harshcht/cummins-auxilliary-boards/aux_PS/3d/PXO7812-500-S.stp

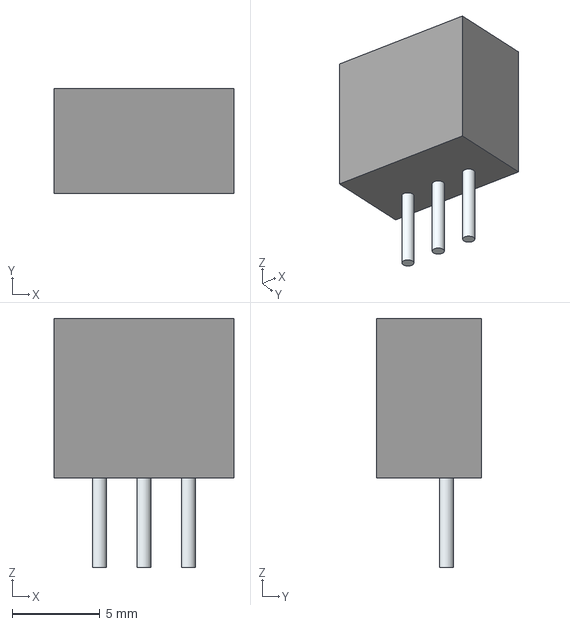
[picture p1: CAD file, 2023-04-08]
aux_PS/3d/PXO7812-500-S.stp
10.3 x 6.00 x 14.2 mm
Leads
