harshcht/cummins-auxilliary-boards/DSP_board/3d/SN74S1053NSR.stp

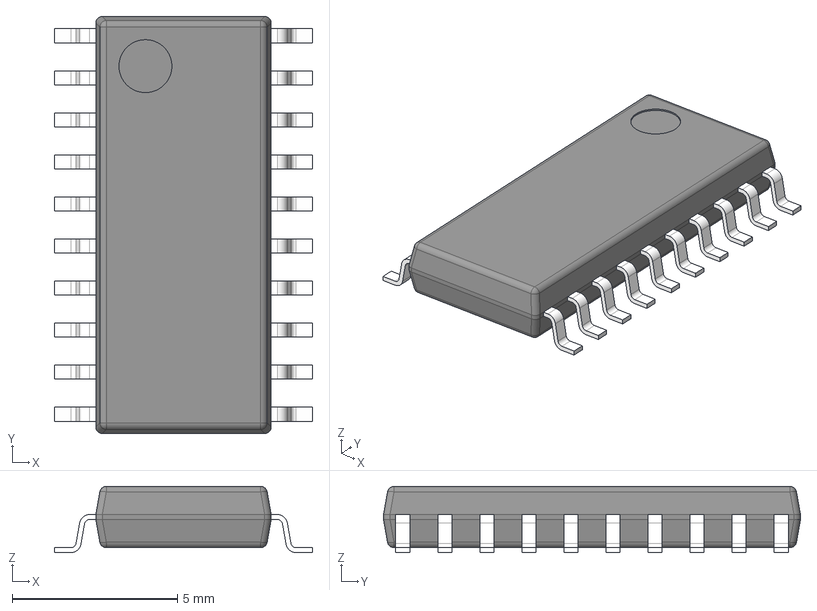
[picture p2: CAD file, 2023-04-17]
DSP_board/3d/SN74S1053NSR.stp
7.80 x 12.6 x 2.00 mm
BODY-SO
LEAD-SO x 20
