harshcht/cummins-auxilliary-boards/LM358S-13/3D/LM358S-13.stp

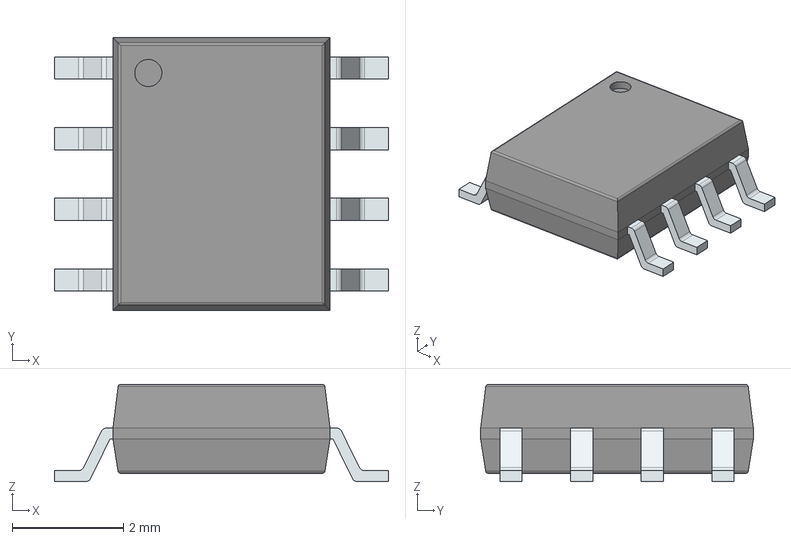
[picture p3: CAD file, 2023-03-20]
LM358S-13/3D/LM358S-13.stp
6.00 x 4.90 x 1.75 mm
PinsArrayLR
