harshcht/cummins-auxilliary-boards/aux_PS/3d/P78E03-1000.stp

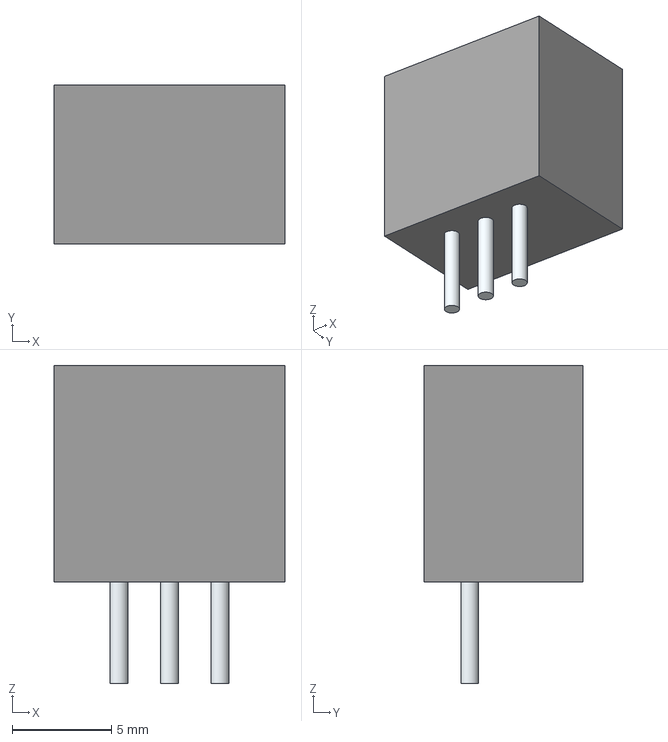
[picture p4: CAD file, 2023-04-08]
aux_PS/3d/P78E03-1000.stp
11.6 x 8.00 x 16.0 mm
Leads
