harshcht/cummins-auxilliary-boards/DSP_board/3d/SDM10M45SD-7-F.stp

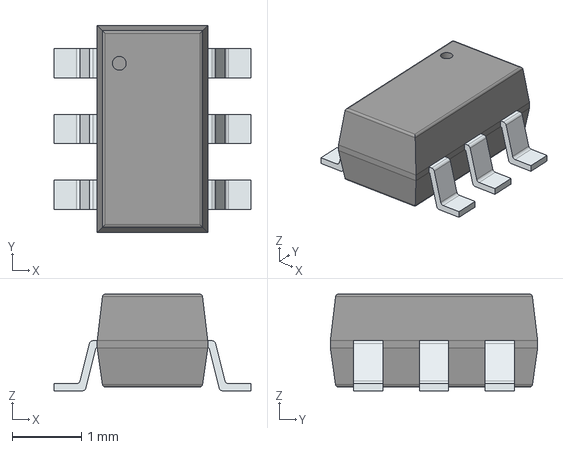
[picture p5: CAD file, 2023-04-17]
DSP_board/3d/SDM10M45SD-7-F.stp
2.85 x 3.00 x 1.40 mm
PinsArrayLR
