harshcht/cummins-auxilliary-boards/aux_PS/3d/PSK-S6C-24.stp

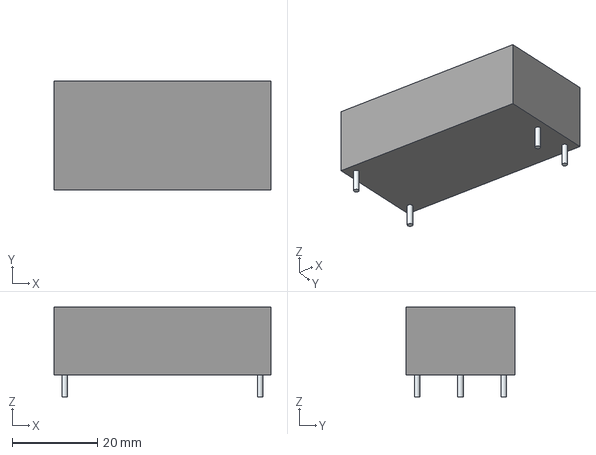
[picture p6: CAD file, 2023-04-08]
aux_PS/3d/PSK-S6C-24.stp
50.8 x 25.4 x 21.0 mm
Leads
