harshcht/cummins-auxilliary-boards/DSP_board/3d/1-84981-0.stp

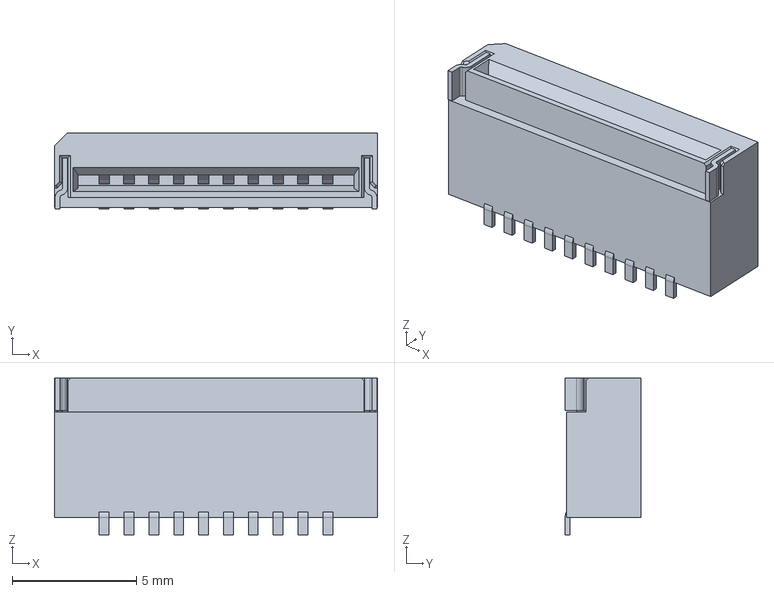
[picture p7: CAD file, 2023-04-08]
DSP_board/3d/1-84981-0.stp
13.0 x 3.05 x 6.30 mm
