harshcht/cummins-auxilliary-boards/aux_PS/3d/EEH-ZA1H100R.stp

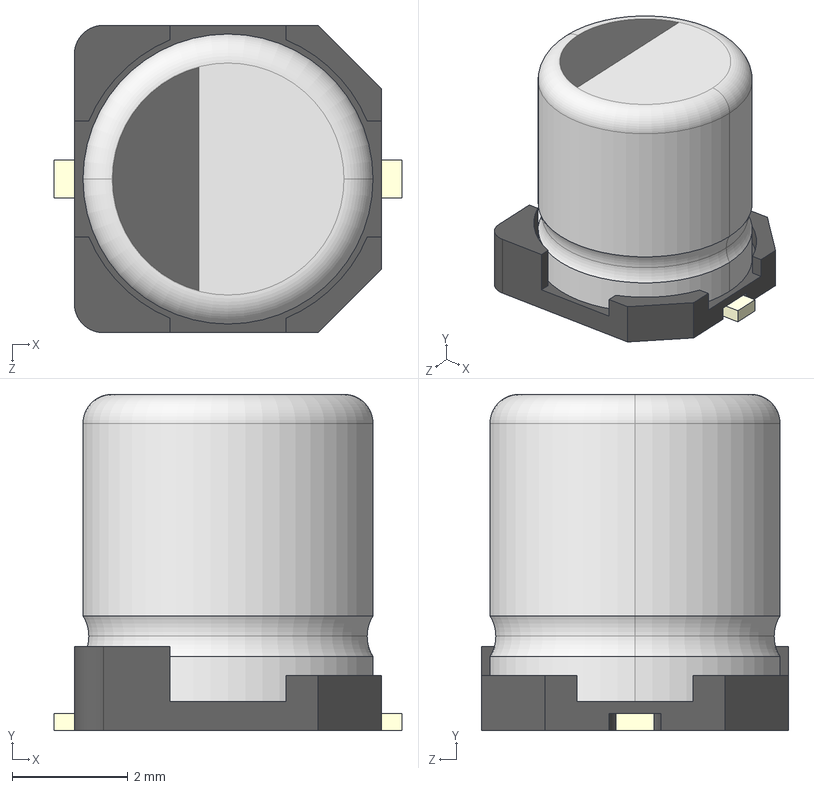
[picture p8: CAD file, 2023-04-08]
aux_PS/3d/EEH-ZA1H100R.stp
6.00 x 5.80 x 5.30 mm
標準SIZE CODE C-001
標準SIZE CODE C-002
標準SIZE CODE C-003 x 2
