harshcht/cummins-auxilliary-boards/DSP_board/DSP_board/F280025CPNQR.stp

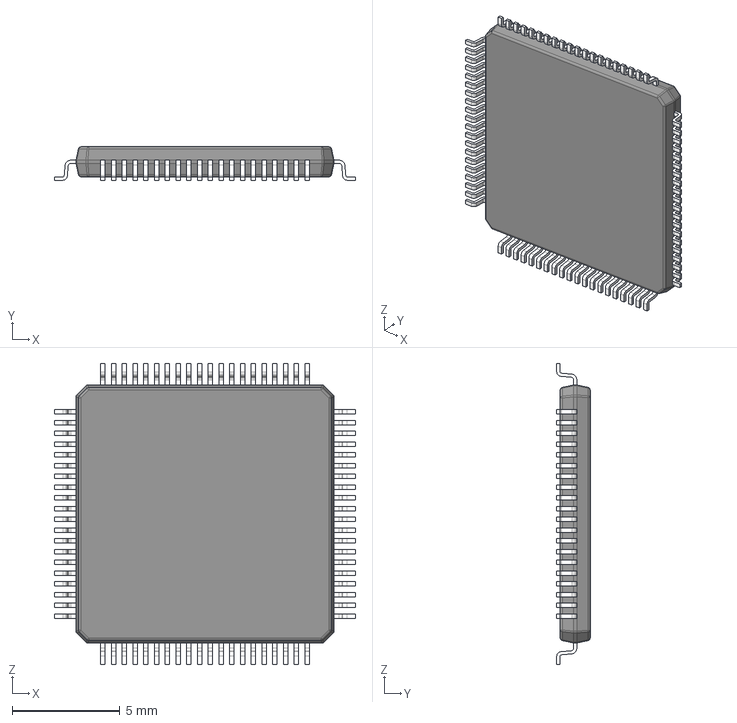
[picture p9: CAD file, 2023-04-08]
DSP_board/DSP_board/F280025CPNQR.stp
14.0 x 1.56 x 14.0 mm
BODY_VHB80A
LEAD_VHB80A x 80
