harshcht/cummins-auxilliary-boards/(list of files, cad)

Other CAD files:
LM358S-13/Allegro/soic127p600x175-8n.psm
LM358S-13/DEHDL/lm358s_13/chips/chips.prt
