harshcht/cummins-auxilliary-boards/(list of files, drawings)

Other design files:
LM358S-13/Altium/LM358S-13.SchLib
LM358S-13/Altium/SOIC127P600X175-8N.PcbLib
