harshcht/cummins-auxilliary-boards/DSP_board/DSP_board/DSP_board.kicad_pcb

## KiCad design DSP_board/DSP_board/DSP_board.kicad_pcb (2023-04-17)

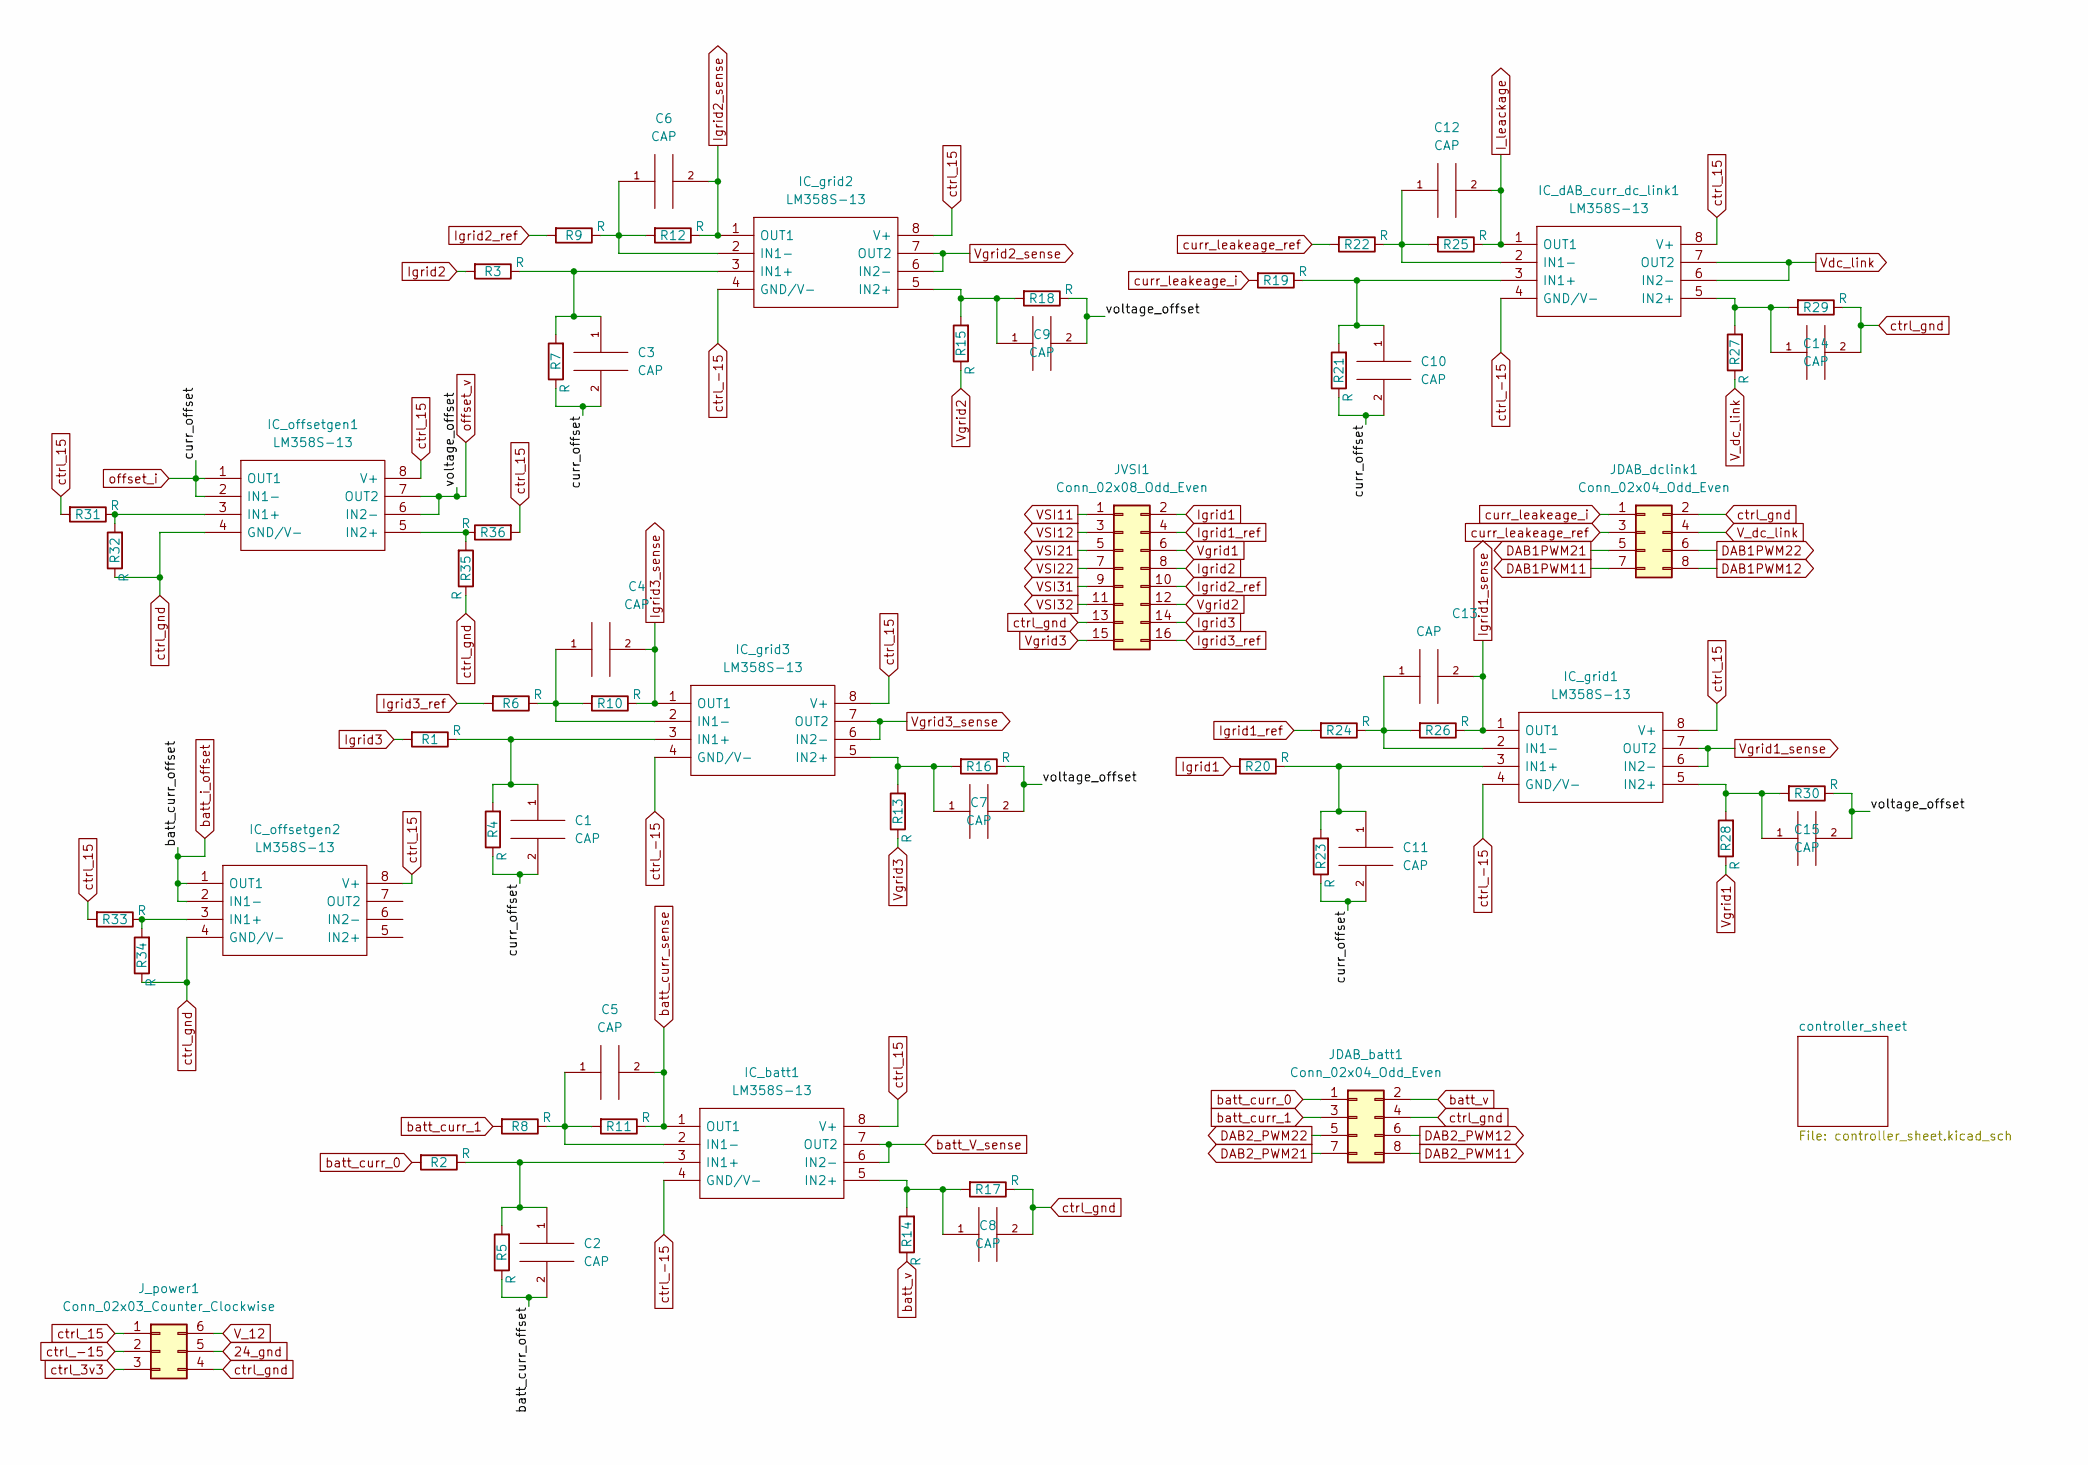
[picture p10: schematic DSP_board.kicad_sch]

Parts:
C1, C2, C3, C4, C5, C6, C7, C8, C9, C10, C11, C12, C13, C14, C15: CAP; C_1206_3216Metric_Pad1.33x1.80mm_HandSolder
IC_batt1: LM358S-13; SOIC127P600X175-8N; Mouser Part Number 621-LM358S-13
IC_dAB_curr_dc_link1: LM358S-13; SOIC127P600X175-8N; Mouser Part Number 621-LM358S-13
IC_grid1, IC_grid2, IC_grid3: LM358S-13; SOIC127P600X175-8N; Mouser Part Number 621-LM358S-13
IC_offsetgen1, IC_offsetgen2: LM358S-13; SOIC127P600X175-8N; Mouser Part Number 621-LM358S-13
JDAB_batt1: Conn_02x04_Odd_Even; PinSocket_2x04_P2.54mm_Vertical
JDAB_dclink1: Conn_02x04_Odd_Even; PinSocket_2x04_P2.54mm_Vertical
JVSI1: Conn_02x08_Odd_Even; PinSocket_2x08_P2.54mm_Vertical
J_power1: Conn_02x03_Counter_Clockwise; PinHeader_2x03_P2.54mm_Vertical
R1, R2, R3, R4, R5, R6, R7, R8, R9, R10, R11, R12, R13, R14, R15, R16, R17, R18, R19, R20, R21, R22, R23, R24, R25, R26, R27, R28, R29, R30, R31, R32, R33, R34, R35, R36: R; R_1206_3216Metric_Pad1.30x1.75mm_HandSolder

Connections:
24_gnd: J_power1.5
DAB1PWM11: JDAB_dclink1.7; also elsewhere on the board
DAB1PWM12: JDAB_dclink1.8; also elsewhere on the board
DAB1PWM21: JDAB_dclink1.5; also elsewhere on the board
DAB1PWM22: JDAB_dclink1.6; also elsewhere on the board
DAB2_PWM11: JDAB_batt1.8; also elsewhere on the board
DAB2_PWM12: JDAB_batt1.6; also elsewhere on the board
DAB2_PWM21: JDAB_batt1.7; also elsewhere on the board
DAB2_PWM22: JDAB_batt1.5; also elsewhere on the board
I_leackage: C12.2, IC_dAB_curr_dc_link1.1 (OUT1), R25.1; also elsewhere on the board
Igrid1: JVSI1.2, R20.2
Igrid1_ref: JVSI1.4, R24.2
Igrid1_sense: C13.2, IC_grid1.1 (OUT1), R26.1; also elsewhere on the board
Igrid2: JVSI1.8, R3.2
Igrid2_ref: JVSI1.10, R9.2
Igrid2_sense: C6.2, IC_grid2.1 (OUT1), R12.1; also elsewhere on the board
Igrid3: JVSI1.14, R1.2
Igrid3_ref: JVSI1.16, R6.2
Igrid3_sense: C4.2, IC_grid3.1 (OUT1), R10.1; also elsewhere on the board
unnamed: C1.1, IC_grid3.3 (IN1+), R1.1, R4.2
unnamed: C2.1, IC_batt1.3 (IN1+), R2.1, R5.2
unnamed: C3.1, IC_grid2.3 (IN1+), R3.1, R7.2
unnamed: C4.1, IC_grid3.2 (IN1-), R6.1, R10.2
unnamed: C5.1, IC_batt1.2 (IN1-), R8.1, R11.2
unnamed: C6.1, IC_grid2.2 (IN1-), R9.1, R12.2
unnamed: C7.1, IC_grid3.5 (IN2+), R13.2, R16.2
unnamed: C8.1, IC_batt1.5 (IN2+), R14.2, R17.2
unnamed: C9.1, IC_grid2.5 (IN2+), R15.2, R18.2
unnamed: C10.1, IC_dAB_curr_dc_link1.3 (IN1+), R19.1, R21.2
unnamed: C11.1, IC_grid1.3 (IN1+), R20.1, R23.2
unnamed: C12.1, IC_dAB_curr_dc_link1.2 (IN1-), R22.1, R25.2
unnamed: C13.1, IC_grid1.2 (IN1-), R24.1, R26.2
unnamed: C14.1, IC_dAB_curr_dc_link1.5 (IN2+), R27.2, R29.2
unnamed: C15.1, IC_grid1.5 (IN2+), R28.2, R30.2
unnamed: IC_offsetgen1.3 (IN1+), R31.1, R32.2
unnamed: IC_offsetgen1.5 (IN2+), R35.2, R36.1
unnamed: IC_offsetgen2.3 (IN1+), R33.1, R34.2
VSI11: JVSI1.1; also elsewhere on the board
VSI12: JVSI1.3; also elsewhere on the board
VSI21: JVSI1.5; also elsewhere on the board
VSI22: JVSI1.7; also elsewhere on the board
VSI31: JVSI1.9; also elsewhere on the board
VSI32: JVSI1.11; also elsewhere on the board
V_12: J_power1.6
V_dc_link: JDAB_dclink1.4, R27.1
Vdc_link: IC_dAB_curr_dc_link1.6 (IN2-), IC_dAB_curr_dc_link1.7 (OUT2); also elsewhere on the board
Vgrid1: JVSI1.6, R28.1
Vgrid1_sense: IC_grid1.6 (IN2-), IC_grid1.7 (OUT2); also elsewhere on the board
Vgrid2: JVSI1.12, R15.1
Vgrid2_sense: IC_grid2.6 (IN2-), IC_grid2.7 (OUT2); also elsewhere on the board
Vgrid3: JVSI1.15, R13.1
Vgrid3_sense: IC_grid3.6 (IN2-), IC_grid3.7 (OUT2); also elsewhere on the board
batt_V_sense: IC_batt1.6 (IN2-), IC_batt1.7 (OUT2); also elsewhere on the board
batt_curr_0: JDAB_batt1.1, R2.2
batt_curr_1: JDAB_batt1.3, R8.2
batt_curr_sense: C5.2, IC_batt1.1 (OUT1), R11.1; also elsewhere on the board
batt_i_offset: C2.2, IC_offsetgen2.1 (OUT1), IC_offsetgen2.2 (IN1-), R5.1; also elsewhere on the board
batt_v: JDAB_batt1.2, R14.1
ctrl_3v3: J_power1.3; also elsewhere on the board
ctrl_15: IC_batt1.8 (V+), IC_dAB_curr_dc_link1.8 (V+), IC_grid1.8 (V+), IC_grid2.8 (V+), IC_grid3.8 (V+), IC_offsetgen1.8 (V+), IC_offsetgen2.8 (V+), J_power1.1, R31.2, R33.2, R36.2; also elsewhere on the board
ctrl_-15: IC_batt1.4 (GND/V-), IC_dAB_curr_dc_link1.4 (GND/V-), IC_grid1.4 (GND/V-), IC_grid2.4 (GND/V-), IC_grid3.4 (GND/V-), J_power1.2
ctrl_gnd: C8.2, C14.2, IC_offsetgen1.4 (GND/V-), IC_offsetgen2.4 (GND/V-), JDAB_batt1.4, JDAB_dclink1.2, JVSI1.13, J_power1.4, R17.1, R29.1, R32.1, R34.1, R35.1; also elsewhere on the board
curr_leakeage_i: JDAB_dclink1.1, R19.2
curr_leakeage_ref: JDAB_dclink1.3, R22.2
offset_i: C1.2, C3.2, C10.2, C11.2, IC_offsetgen1.1 (OUT1), IC_offsetgen1.2 (IN1-), R4.1, R7.1, R21.1, R23.1; also elsewhere on the board
offset_v: C7.2, C9.2, C15.2, IC_offsetgen1.6 (IN2-), IC_offsetgen1.7 (OUT2), R16.1, R18.1, R30.1; also elsewhere on the board

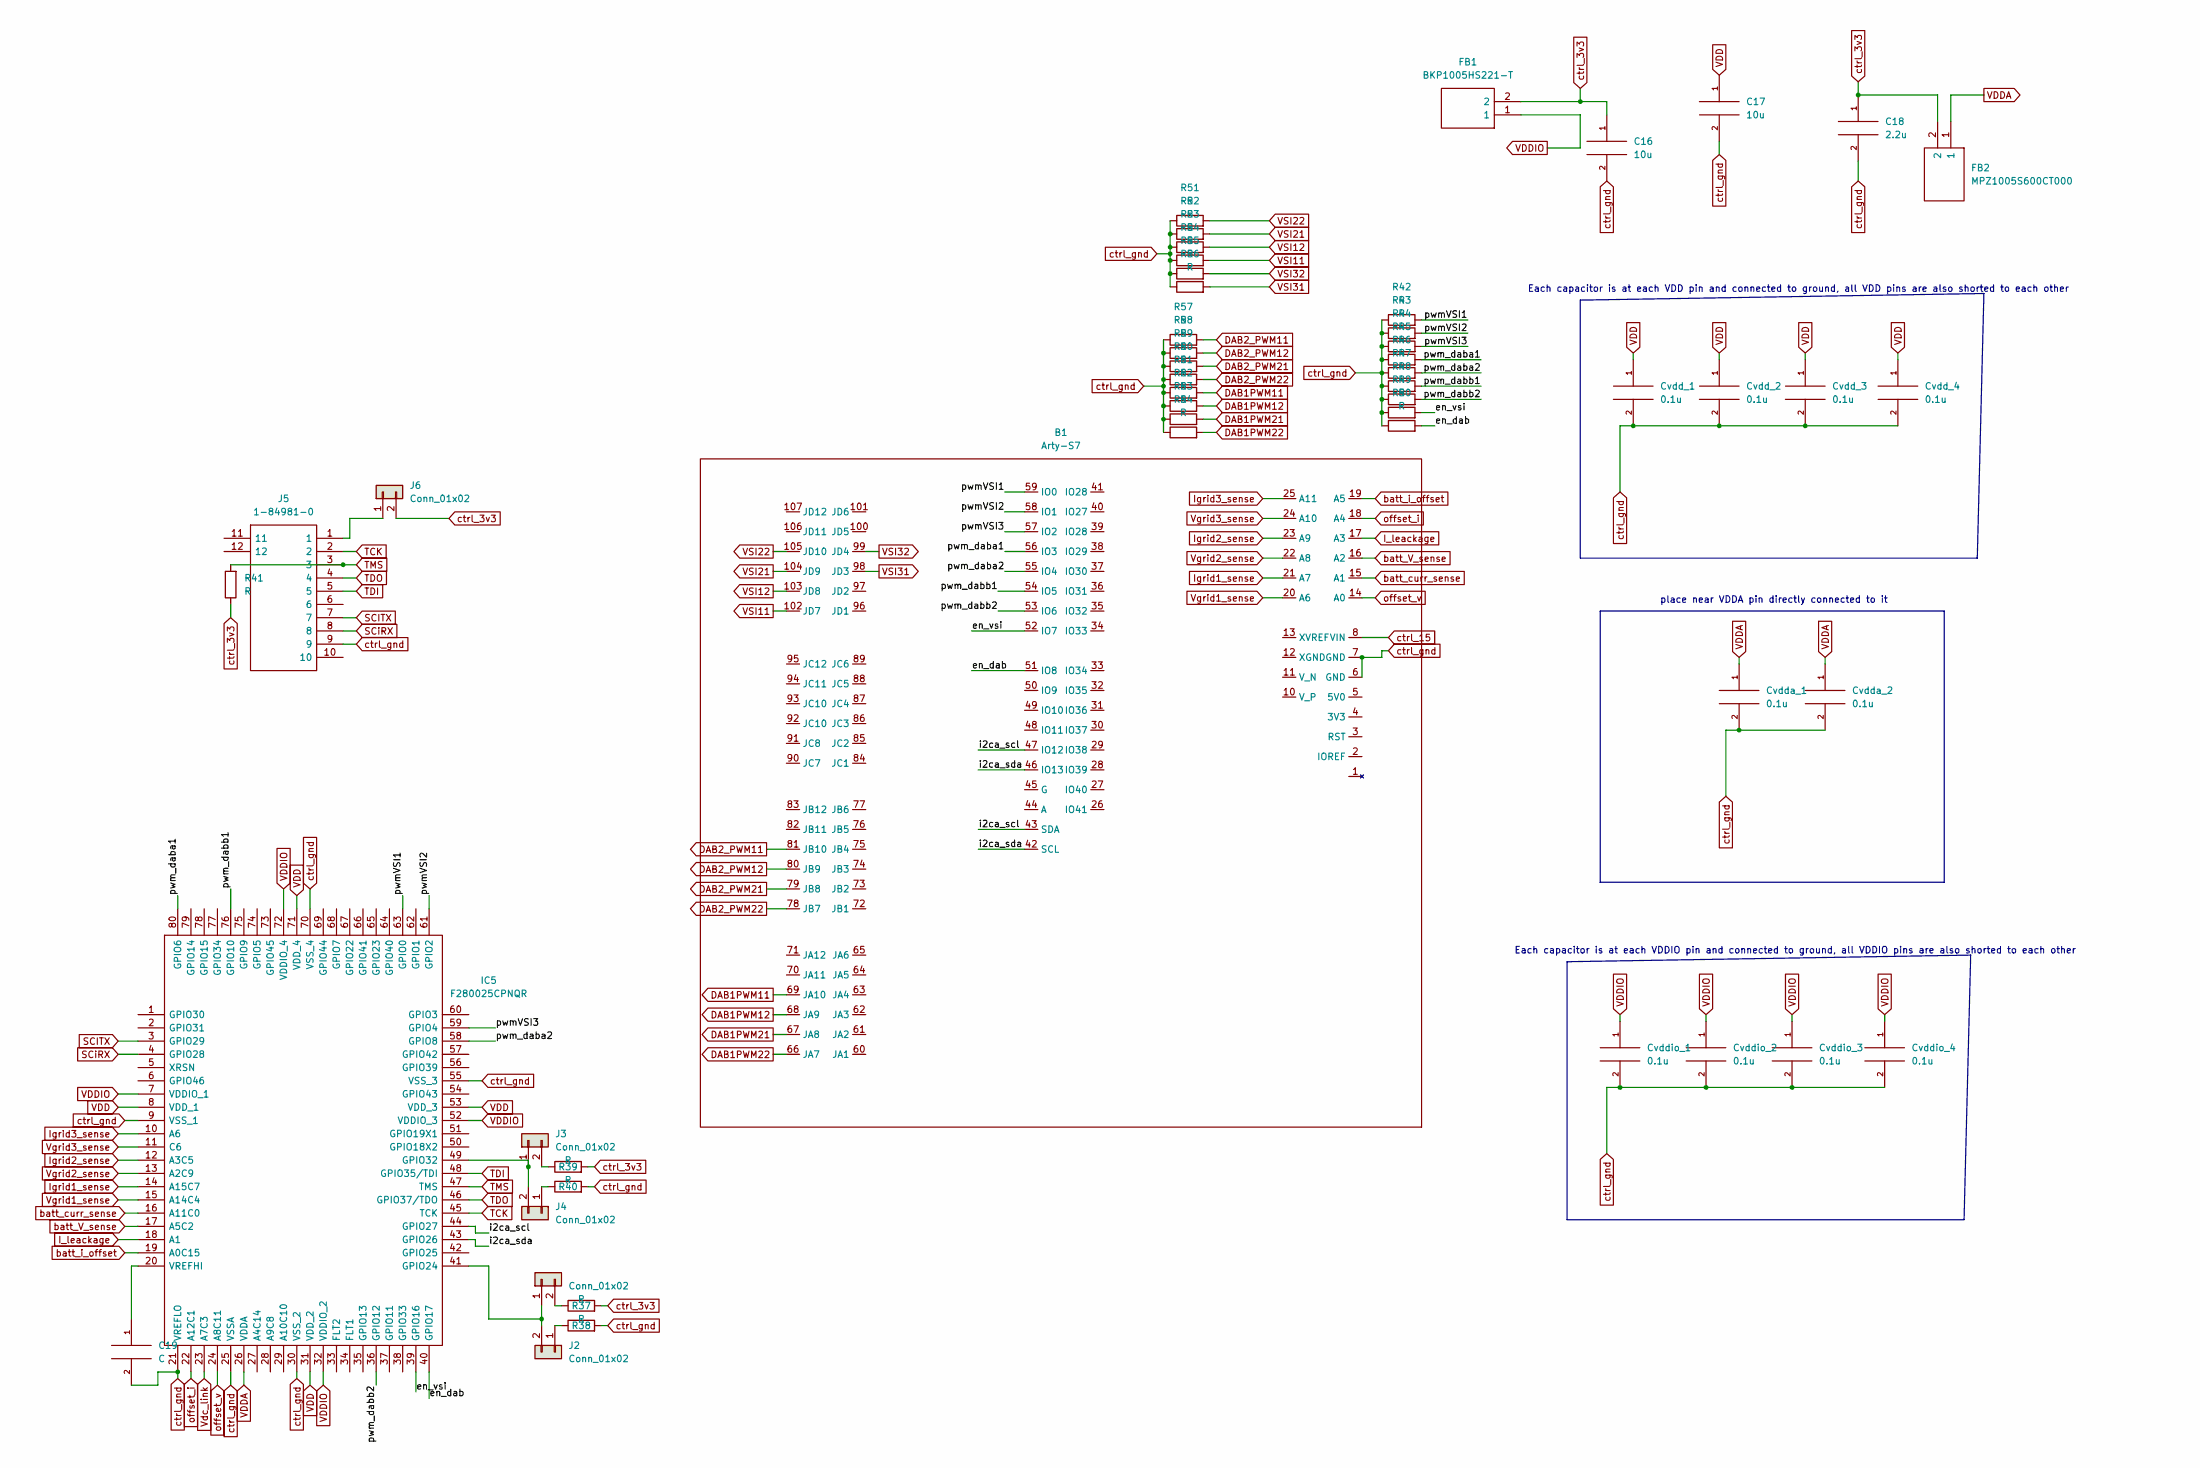
[picture p11: schematic controller_sheet.kicad_sch]

Parts:
B1: Arty-S7
C16, C17: 10u; C_0603_1608Metric_Pad1.08x0.95mm_HandSolder
C18: 2.2u; C_0603_1608Metric_Pad1.08x0.95mm_HandSolder
C19: C; C_0805_2012Metric_Pad1.18x1.45mm_HandSolder
Cvdd_1, Cvdd_2, Cvdd_3, Cvdd_4: 0.1u; C_0603_1608Metric_Pad1.08x0.95mm_HandSolder
Cvdda_1, Cvdda_2: 0.1u; C_0603_1608Metric_Pad1.08x0.95mm_HandSolder
Cvddio_1, Cvddio_2, Cvddio_3, Cvddio_4: 0.1u; C_0603_1608Metric_Pad1.08x0.95mm_HandSolder
FB1: BKP1005HS221-T; BEADC1005X55N; Mouser Part Number 963-BKP1005HS221-T
FB2: MPZ1005S600CT000; BEADC1005X55N; Mouser Part Number 810-MPZ1005S600CT000
IC5: F280025CPNQR; f280025c; Mouser Part Number 595-F280025CPNQR
J1, J2, J3, J4, J6: Conn_01x02; PinHeader_1x02_P2.54mm_Vertical
J5: 1-84981-0; 1849810; Mouser Part Number 571-1-84981-0
R37, R38, R39, R40, R41: R; R_1206_3216Metric_Pad1.30x1.75mm_HandSolder
R42, R43, R44, R45, R46, R47, R48, R49, R50, R51, R52, R53, R54, R55, R56, R57, R58, R59, R60, R61, R62, R63, R64: R; C_1206_3216Metric_Pad1.33x1.80mm_HandSolder

Connections:
/controller_sheet/en_dab: B1.51 (IO8), IC5.40 (GPIO17), R50.2
/controller_sheet/en_vsi: B1.52 (IO7), IC5.39 (GPIO16), R49.2
/controller_sheet/i2ca_scl: B1.43 (SDA), B1.47 (IO12), IC5.44 (GPIO27)
/controller_sheet/i2ca_sda: B1.42 (SCL), B1.46 (IO13), IC5.43 (GPIO26)
/controller_sheet/pwmVSI1: B1.59 (IO0), IC5.63 (GPIO0), R42.2
/controller_sheet/pwmVSI2: B1.58 (IO1), IC5.61 (GPIO2), R43.2
/controller_sheet/pwmVSI3: B1.57 (IO2), IC5.59 (GPIO4), R44.2
/controller_sheet/pwm_daba1: B1.56 (IO3), IC5.80 (GPIO6), R45.2
/controller_sheet/pwm_daba2: B1.55 (IO4), IC5.58 (GPIO8), R46.2
/controller_sheet/pwm_dabb1: B1.54 (IO5), IC5.76 (GPIO10), R47.2
/controller_sheet/pwm_dabb2: B1.53 (IO6), IC5.36 (GPIO12), R48.2
DAB1PWM11: B1.69 (JA10), R61.2; also elsewhere on the board
DAB1PWM12: B1.68 (JA9), R62.2; also elsewhere on the board
DAB1PWM21: B1.67 (JA8), R63.2; also elsewhere on the board
DAB1PWM22: B1.66 (JA7), R64.2; also elsewhere on the board
DAB2_PWM11: B1.81 (JB10), R57.2; also elsewhere on the board
DAB2_PWM12: B1.80 (JB9), R58.2; also elsewhere on the board
DAB2_PWM21: B1.79 (JB8), R59.2; also elsewhere on the board
DAB2_PWM22: B1.78 (JB7), R60.2; also elsewhere on the board
I_leackage: B1.17 (A3), IC5.18 (A1); also elsewhere on the board
Igrid1_sense: B1.21 (A7), IC5.14 (A15C7); also elsewhere on the board
Igrid2_sense: B1.23 (A9), IC5.12 (A3C5); also elsewhere on the board
Igrid3_sense: B1.25 (A11), IC5.10 (A6); also elsewhere on the board
unnamed: C19.1, IC5.20 (VREFHI)
unnamed: IC5.41 (GPIO24), J1.1, J2.2
unnamed: IC5.49 (GPIO32), J3.1, J4.2
unnamed: J1.2, R37.1
unnamed: J2.1, R38.1
unnamed: J3.2, R39.1
unnamed: J4.1, R40.1
unnamed: J5.1, J6.1
SCITX: IC5.3 (GPIO29), J5.7
SCiRX: IC5.4 (GPIO28), J5.8
TCK: IC5.45 (TCK), J5.2
TDI: IC5.48 (GPIO35/TDI), J5.5
TDO: IC5.46 (GPIO37/TDO), J5.4
TMS: IC5.47 (TMS), J5.3, R41.2
VDD: C17.1, Cvdd_1.1, Cvdd_2.1, Cvdd_3.1, Cvdd_4.1, IC5.8 (VDD_1), IC5.31 (VDD_2), IC5.53 (VDD_3), IC5.71 (VDD_4)
VDDA: Cvdda_1.1, Cvdda_2.1, FB2.1, IC5.26 (VDDA)
VDDIO: Cvddio_1.1, Cvddio_2.1, Cvddio_3.1, Cvddio_4.1, FB1.1, IC5.7 (VDDIO_1), IC5.32 (VDDIO_2), IC5.52 (VDDIO_3), IC5.72 (VDDIO_4)
VSI11: B1.102 (JD7), R54.2; also elsewhere on the board
VSI12: B1.103 (JD8), R53.2; also elsewhere on the board
VSI21: B1.104 (JD9), R52.2; also elsewhere on the board
VSI22: B1.105 (JD10), R51.2; also elsewhere on the board
VSI31: B1.98 (JD3), R56.2; also elsewhere on the board
VSI32: B1.99 (JD4), R55.2; also elsewhere on the board
Vdc_link: IC5.23 (A7C3); also elsewhere on the board
Vgrid1_sense: B1.20 (A6), IC5.15 (A14C4); also elsewhere on the board
Vgrid2_sense: B1.22 (A8), IC5.13 (A2C9); also elsewhere on the board
Vgrid3_sense: B1.24 (A10), IC5.11 (C6); also elsewhere on the board
batt_V_sense: B1.16 (A2), IC5.17 (A5C2); also elsewhere on the board
batt_curr_sense: B1.15 (A1), IC5.16 (A11C0); also elsewhere on the board
batt_i_offset: B1.19 (A5), IC5.19 (A0C15); also elsewhere on the board
ctrl_3v3: C16.1, C18.1, FB1.2, FB2.2, J6.2, R37.2, R39.2, R41.1; also elsewhere on the board
ctrl_15: B1.8 (VIN); also elsewhere on the board
ctrl_gnd: B1.6 (GND), B1.7 (GND), C16.2, C17.2, C18.2, C19.2, Cvdd_1.2, Cvdd_2.2, Cvdd_3.2, Cvdd_4.2, Cvdda_1.2, Cvdda_2.2, Cvddio_1.2, Cvddio_2.2, Cvddio_3.2, Cvddio_4.2, IC5.9 (VSS_1), IC5.21 (VREFLO), IC5.25 (VSSA), IC5.30 (VSS_2), IC5.55 (VSS_3), IC5.70 (VSS_4), J5.9, R38.2, R40.2, R42.1, R43.1, R44.1, R45.1, R46.1, R47.1, R48.1, R49.1, R50.1, R51.1, R52.1, R53.1, R54.1, R55.1, R56.1, R57.1, R58.1, R59.1, R60.1, R61.1, R62.1, R63.1, R64.1; also elsewhere on the board
offset_i: B1.18 (A4), IC5.22 (A12C1); also elsewhere on the board
offset_v: B1.14 (A0), IC5.24 (A8C11); also elsewhere on the board

Notes on the sheet:
Each capacitor is at each VDD pin and connected to ground, all VDD pins are also shorted to each other
place near VDDA pin directly connected to it
Each capacitor is at each VDDIO pin and connected to ground, all VDDIO pins are also shorted to each other

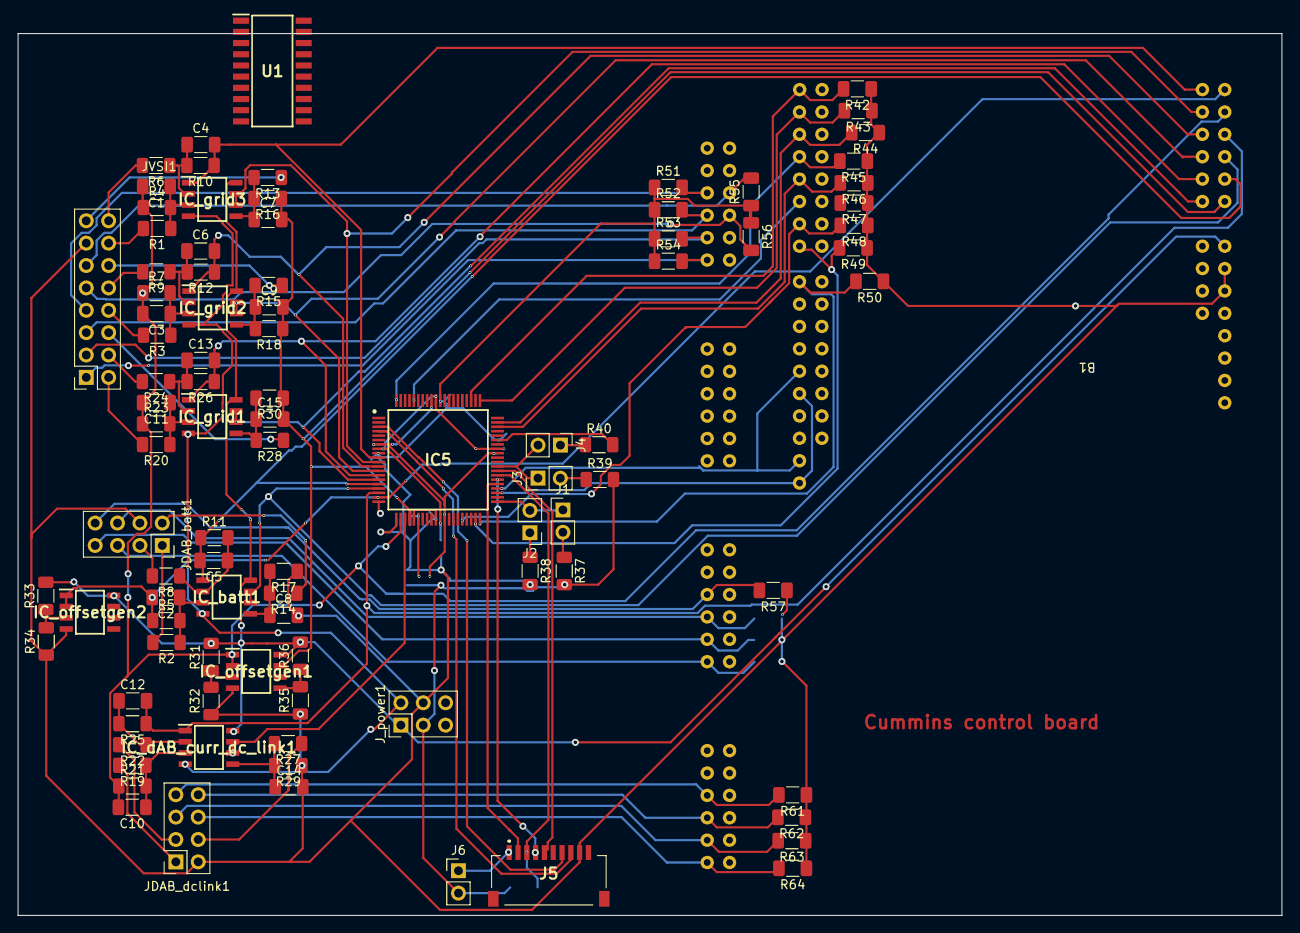
[picture p12: board DSP_board.kicad_pcb from above]

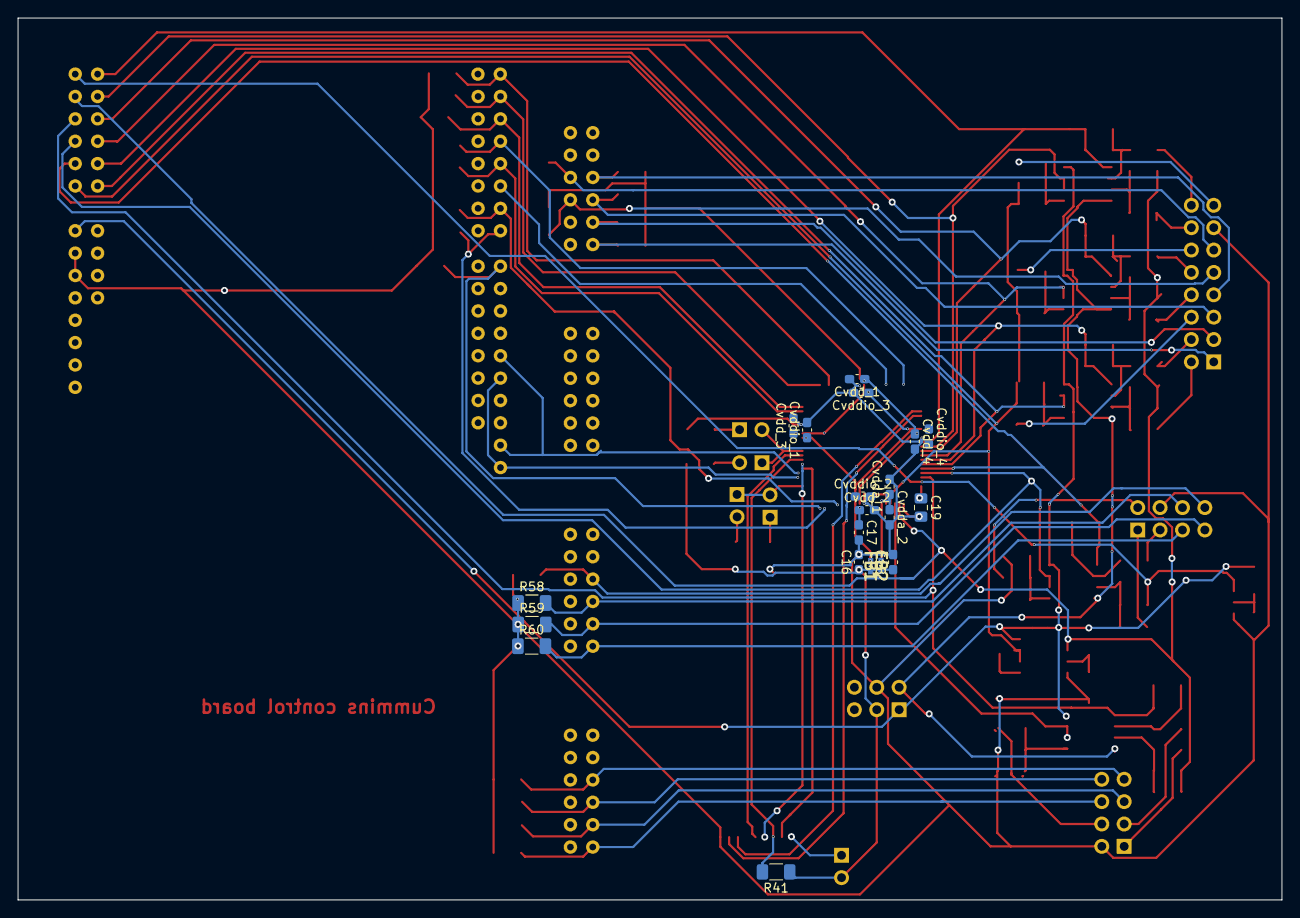
[picture p13: board DSP_board.kicad_pcb from below]

Board: 2 copper layers, 143.5 x 100.1 mm, 115 parts (20 on the bottom side), 92 nets.

Other parts of the board:
U1: SN74S1053NSR; SOIC127P780X200-20N
