harshcht/cummins-auxilliary-boards/aux_PS/aux_PS.kicad_pcb

## KiCad design aux_PS/aux_PS.kicad_pcb (2023-03-20)

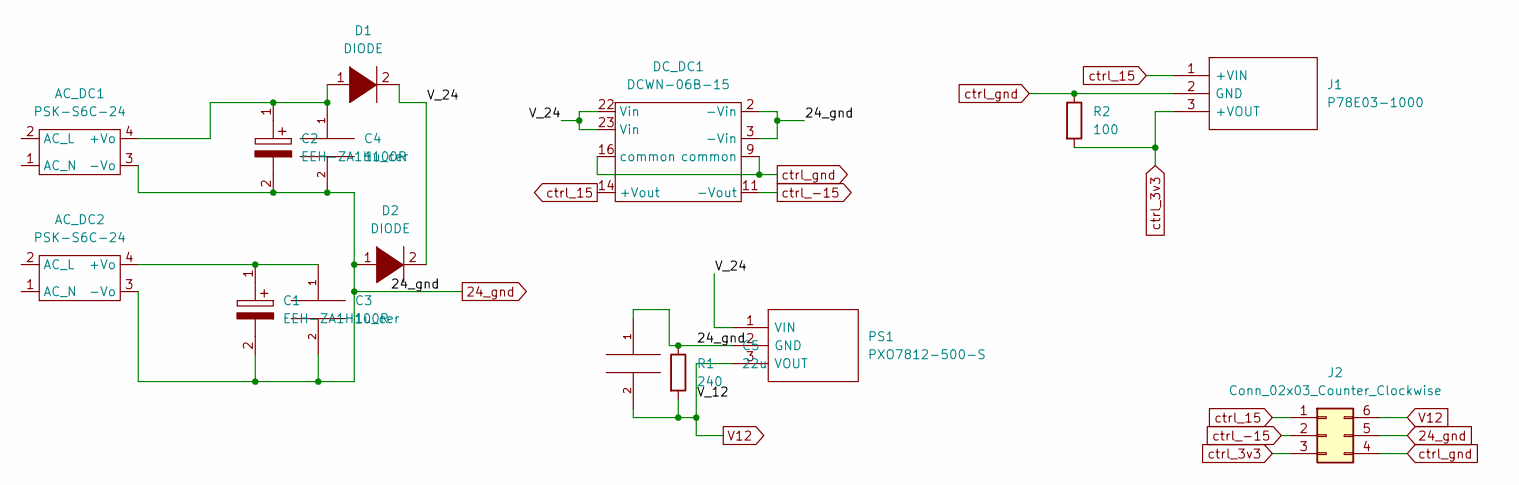
[picture p14: schematic aux_PS.kicad_sch]

Parts:
AC_DC1, AC_DC2: PSK-S6C-24
C1, C2: EEH-ZA1H100R; EEHZA1H100R; Mouser Part Number 667-EEH-ZA1H100R
C3, C4: 1u_cer; C_1206_3216Metric_Pad1.33x1.80mm_HandSolder
C5: 22u; R_1206_3216Metric_Pad1.30x1.75mm_HandSolder
D1, D2: DIODE; D_1206_3216Metric_Pad1.42x1.75mm_HandSolder
DC_DC1: DCWN-06B-15; DCWN-06B
J1: P78E03-1000; P78E031000; Mouser Part Number 490-P78E03-1000
J2: Conn_02x03_Counter_Clockwise; PinSocket_2x03_P2.54mm_Vertical
PS1: PXO7812-500-S; PXO7812500S; Mouser Part Number 490-PXO7812-500-S
R1: 240; R_1206_3216Metric_Pad1.30x1.75mm_HandSolder
R2: 100; R_1206_3216Metric_Pad1.30x1.75mm_HandSolder

Connections:
24_gnd: AC_DC1.3 (-Vo), AC_DC2.3 (-Vo), C1.2, C2.2, C3.2, C4.2, C5.1, D2.1 (K), DC_DC1.2 (-Vin), DC_DC1.3 (-Vin), J2.5, PS1.2 (GND), R1.1
/V_24: D1.2 (A), D2.2 (A), DC_DC1.22 (Vin), DC_DC1.23 (Vin), PS1.1 (VIN)
unnamed: AC_DC1.4 (+Vo), C2.1, C4.1, D1.1 (K)
unnamed: AC_DC2.4 (+Vo), C1.1, C3.1
V12: C5.2, J2.6, PS1.3 (VOUT), R1.2
ctrl_3v3: J1.3 (+VOUT), J2.3, R2.2
ctrl_15: DC_DC1.14 (+Vout), J1.1 (+VIN), J2.1
ctrl_-15: DC_DC1.11 (-Vout), J2.2
ctrl_gnd: DC_DC1.9 (common), DC_DC1.16 (common), J1.2 (GND), J2.4, R2.1

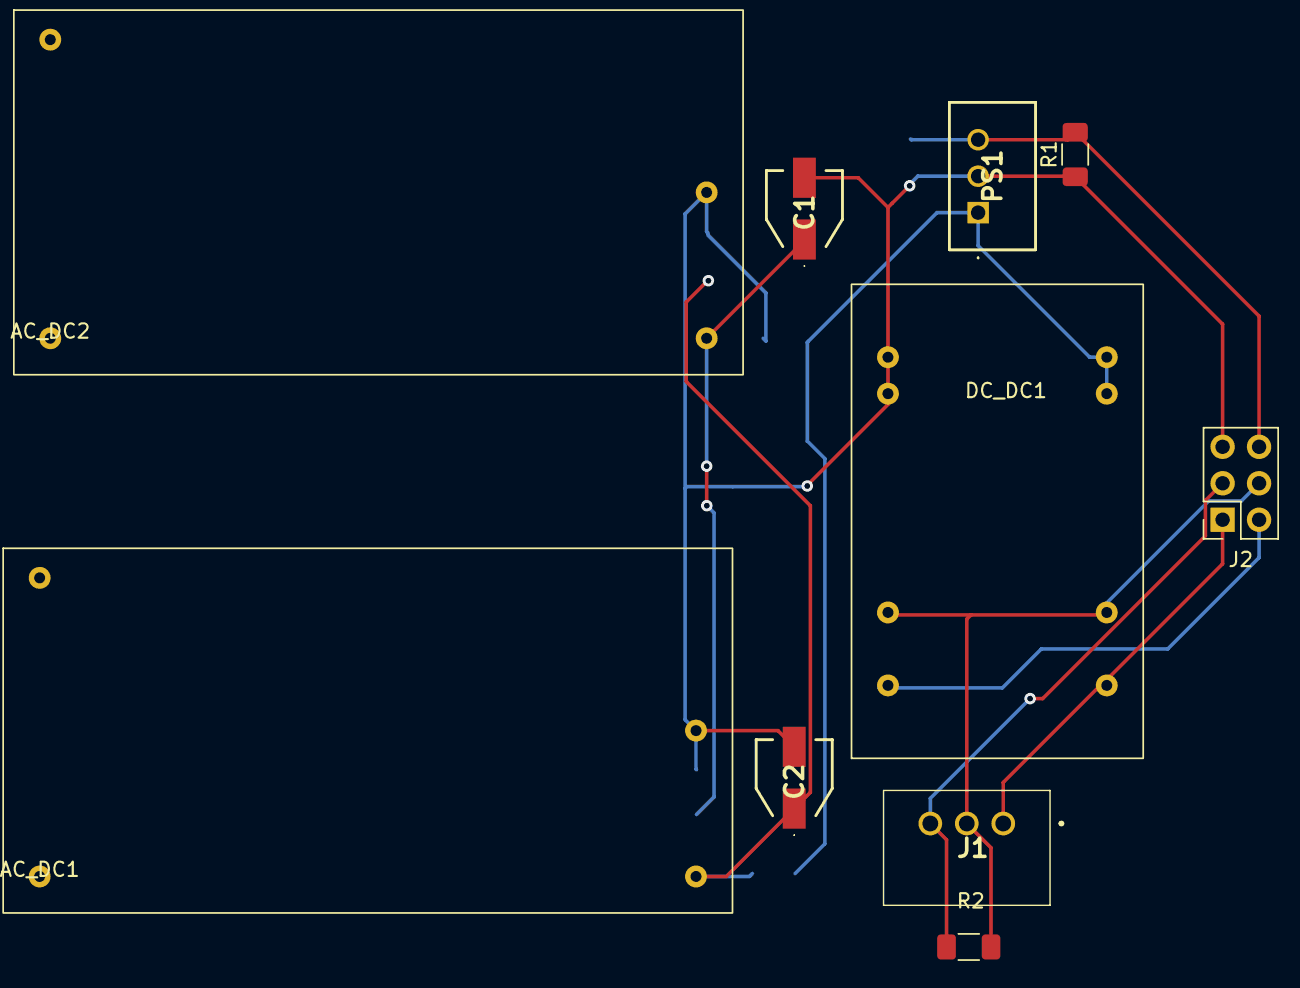
[picture p15: board aux_PS.kicad_pcb from above]

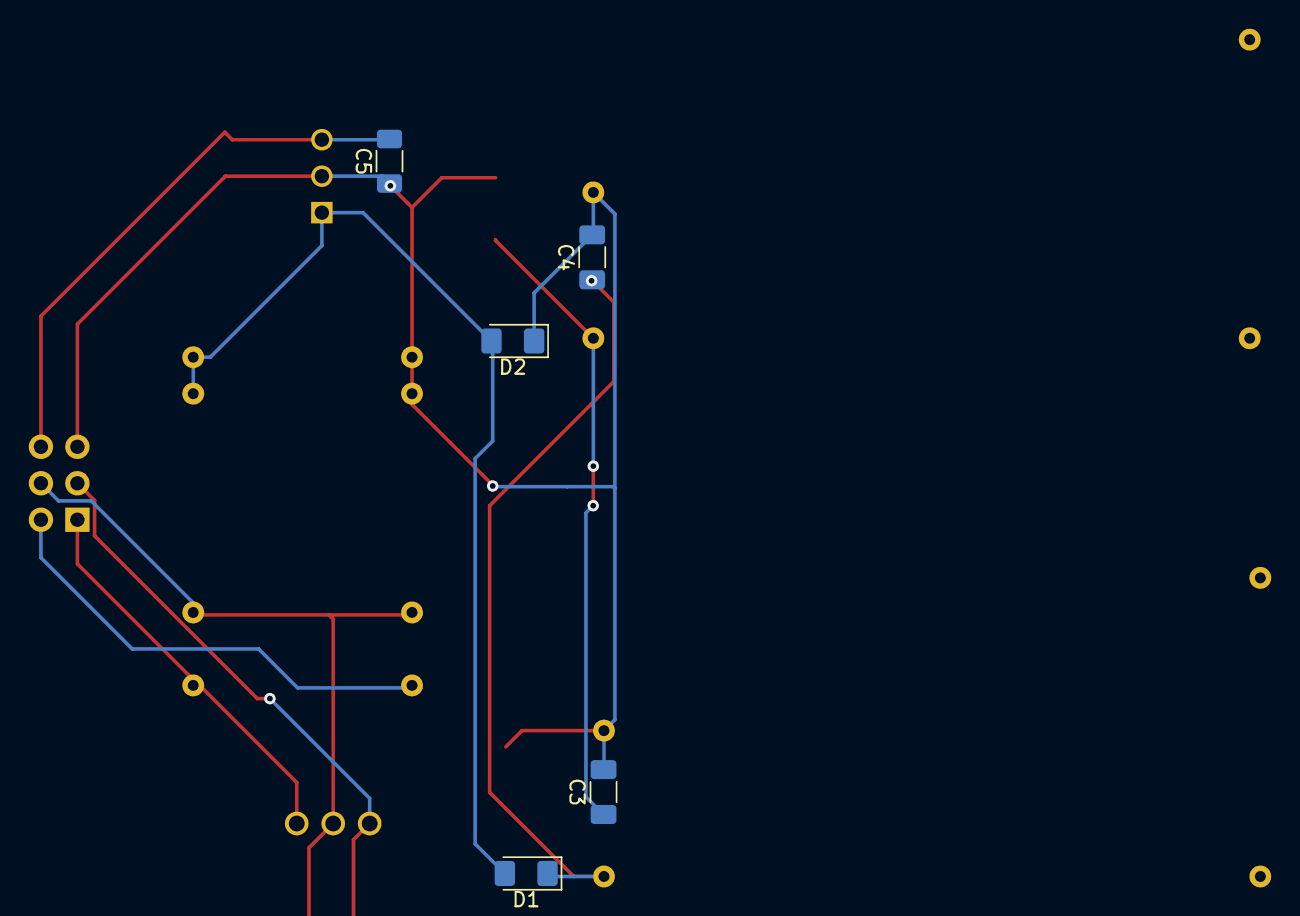
[picture p16: board aux_PS.kicad_pcb from below]

Board: 2 copper layers, 15 parts (5 on the bottom side), 9 nets.
