harshcht/cummins-auxilliary-boards/(commit log)

2023-03-25 including FPGA
    [DSP_board.kicad_pcb, DSP_board.kicad_sch, controller_sheet.kicad_sch]
2023-04-08 Connecting FPGA ADC pins
    [1-84981-0.stp, DSP_board.kicad_pcb, DSP_board.kicad_sch, F280025CPNQR.stp, controller_sheet.kicad_sch]
2023-04-17 adding diodes
    [DSP_board.kicad_pcb, DSP_board.kicad_sch, SDM10M45SD-7-F.stp, SN74S1053NSR.stp, controller_sheet.kicad_sch]
2023-04-17 adding diode footprint
    [DSP_board.kicad_sch, controller_sheet.kicad_sch]
